benvonhandorf/eclipse_sao/eclipse_sao_v1/info/eclipse_sao_v1 - Schematic.pdf

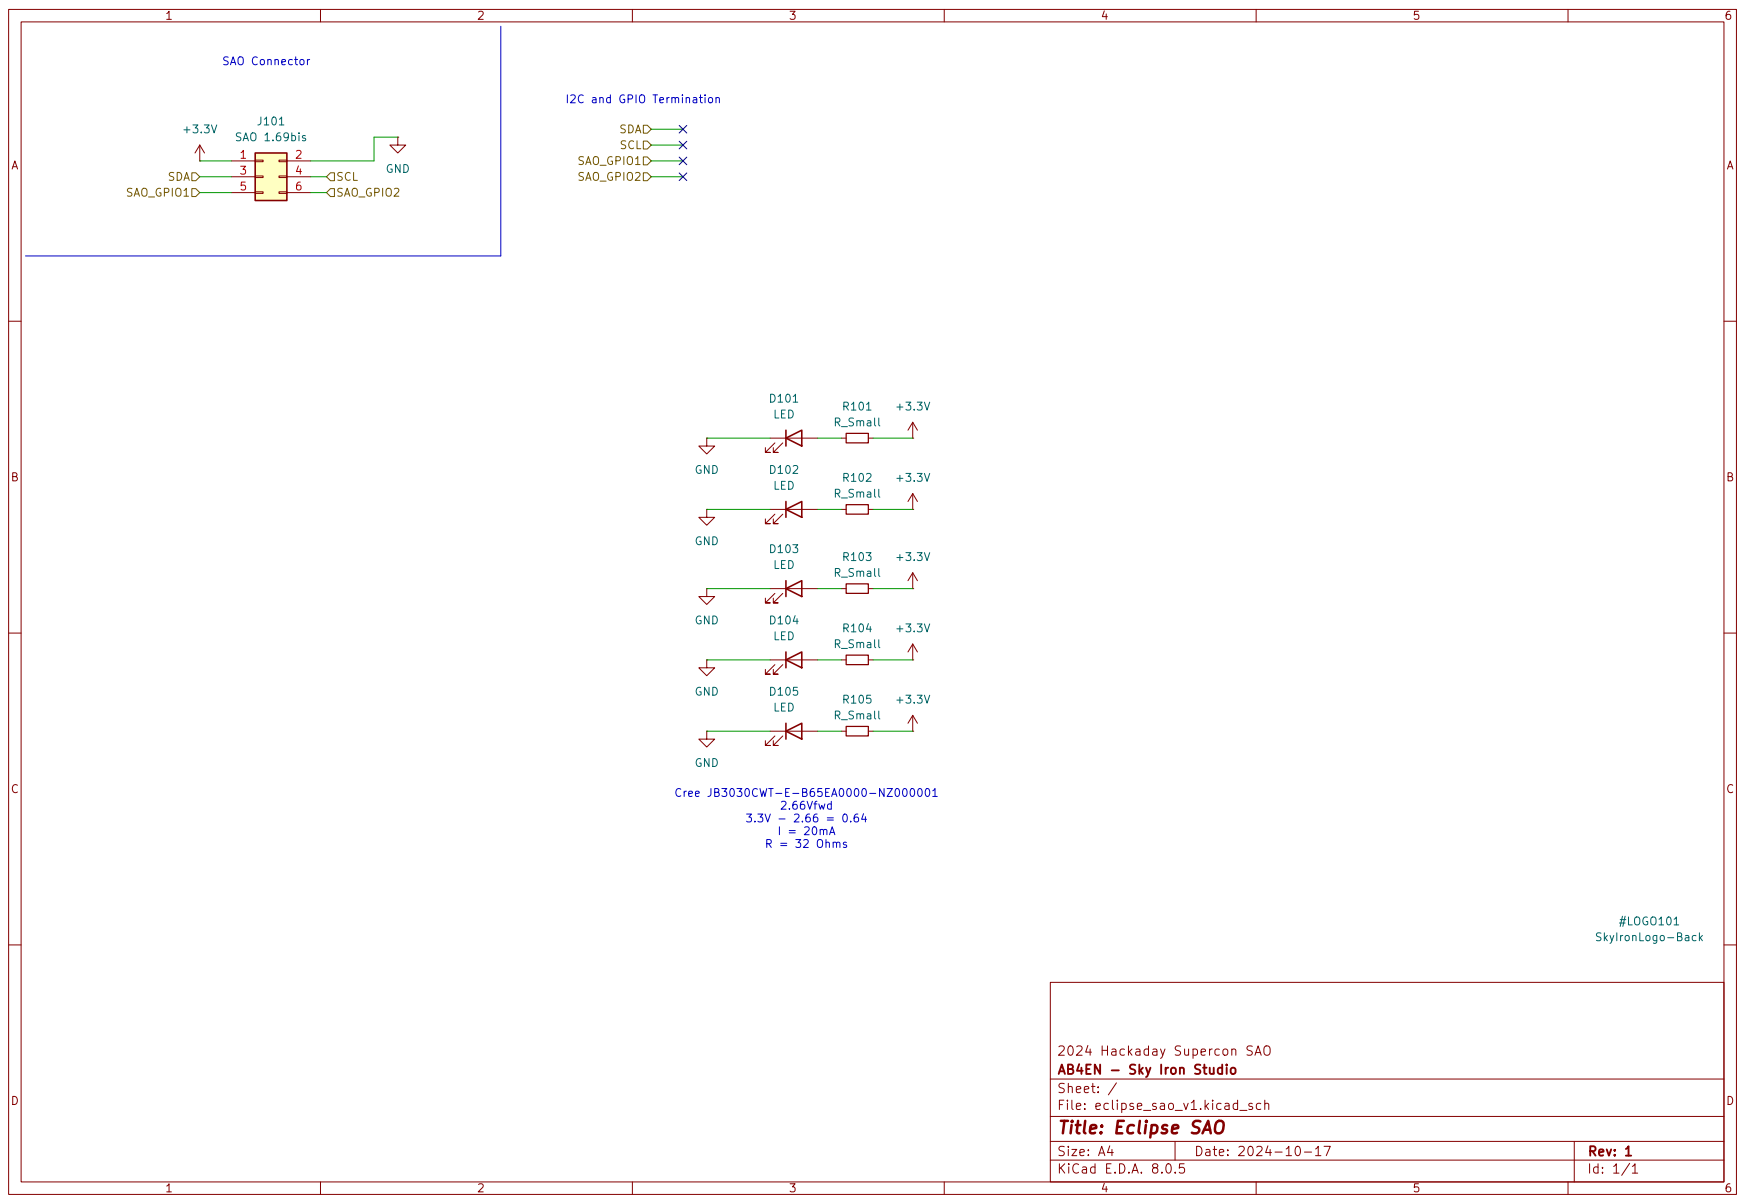
[picture p2: page 1]
