benvonhandorf/eclipse_sao/eclipse_sao_v1/eclipse_sao_v1.kicad_sch

## KiCad design eclipse_sao_v1/eclipse_sao_v1.kicad_sch (2024-10-17)

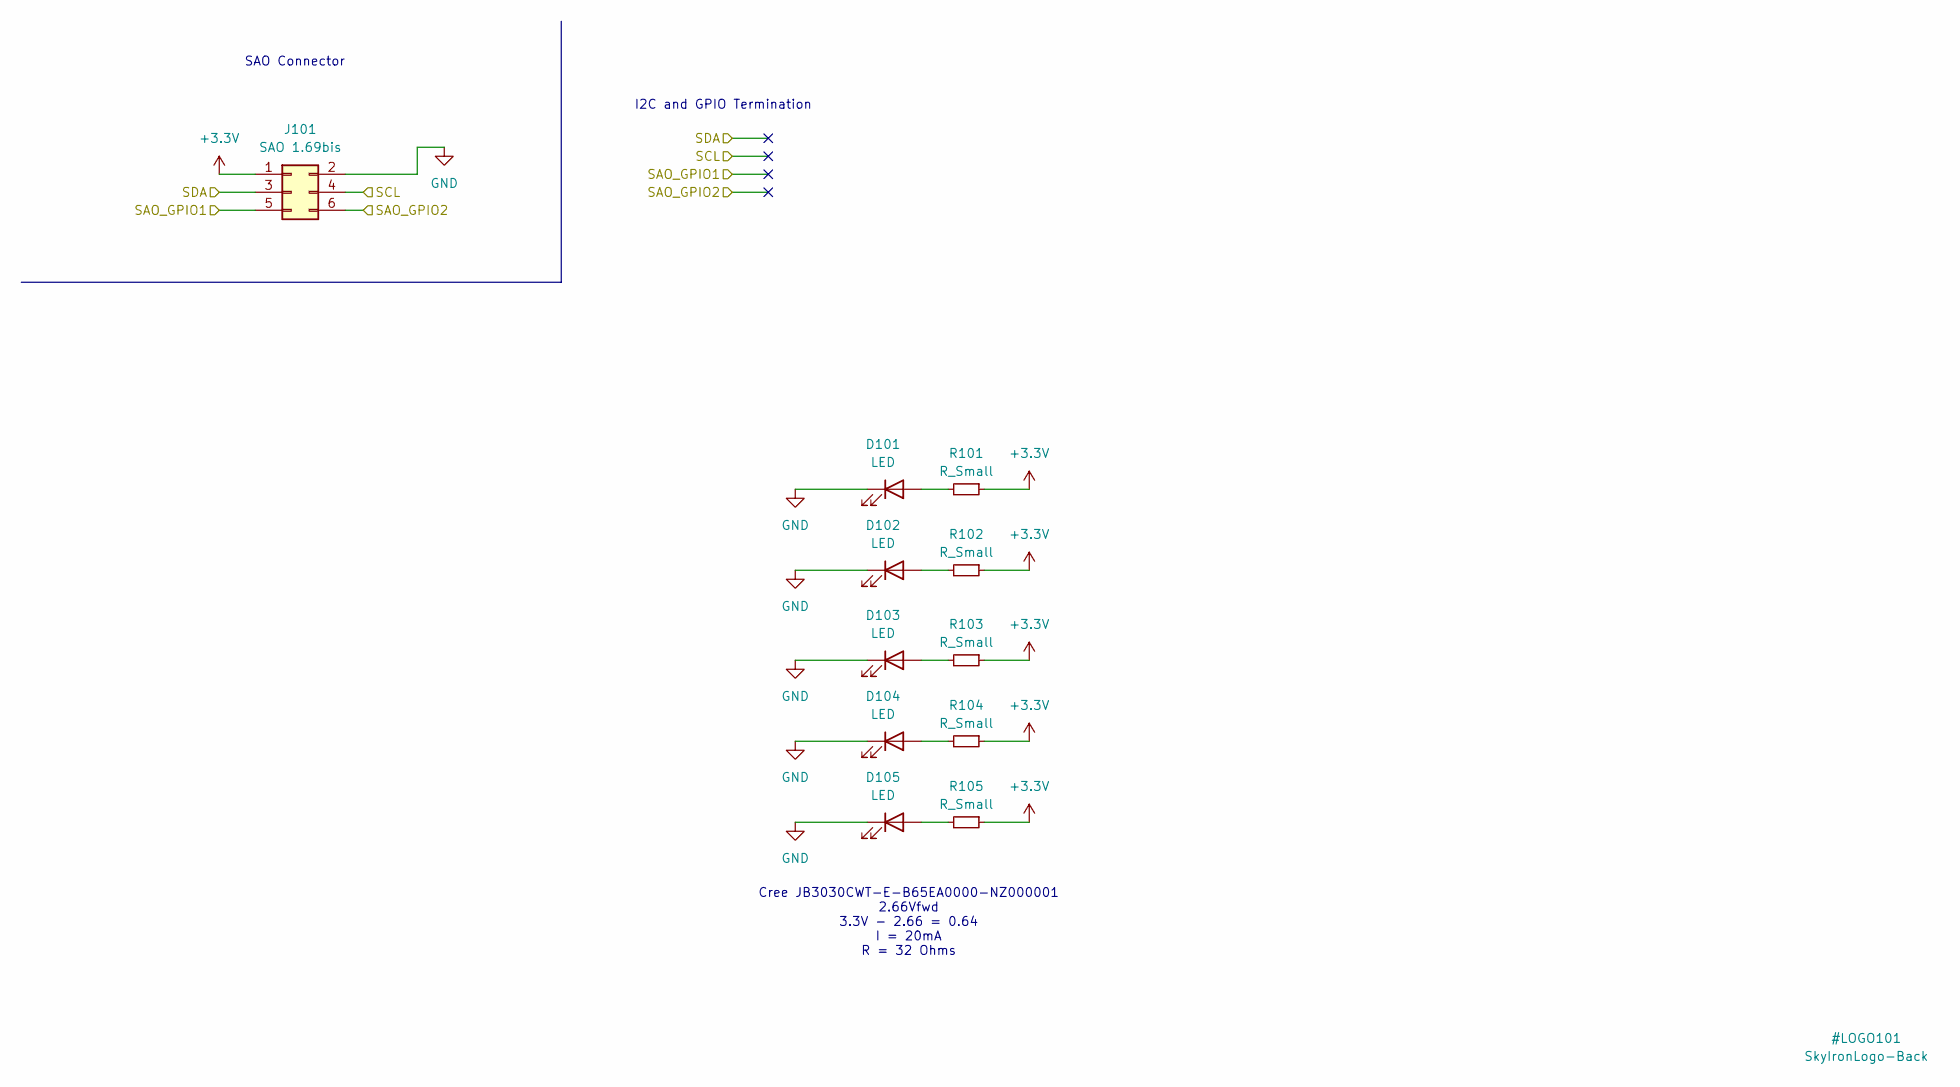
[picture p3: schematic eclipse_sao_v1.kicad_sch]

Parts:
D101, D102, D103, D104: LED; LTW-008ZDCG
D105: LED; JB3030C
J101: SAO 1.69bis; IDC-Header_2x03_P2.54mm_Vertical
R101, R102, R103, R104, R105: R_Small; R_0805_2012Metric

Connections:
+3.3V: J101.1, R101.1, R102.1, R103.1, R104.1, R105.1
GND: D101.1 (K), D102.1 (K), D103.1 (K), D104.1 (K), D105.1 (K), J101.2
unnamed: D101.2 (A), R101.2
unnamed: D102.2 (A), R102.2
unnamed: D103.2 (A), R103.2
unnamed: D104.2 (A), R104.2
unnamed: D105.2 (A), R105.2
SAO_GPIO1: J101.5
SAO_GPIO2: J101.6
SCL: J101.4
SDA: J101.3

Notes on the sheet:
SAO Connector
I2C and GPIO Termination
Cree JB3030CWT-E-B65EA0000-NZ000001 2.66Vfwd 3.3V - 2.66 = 0.64 I = 20mA R = 32 Ohms
